RobotSwastaken/Amunicja/Dokumentacja/Robert Andrzejczuk Przezntacja SMIW.pdf

# SmiW

# Temat Projektu

## Urządzenie mające na celu zapobieganiu kradzieży pojazdu, w którym zostanie zamontowane, poprzez wykrywanie czy dany pojazd się porusza. Po wykryciu ruchu użądzenie zacyna co określony czas wysyłać widomości SMS na wybrany numer telefonu, zawierające

informacje o jego aktualnym położeniu.

# Elementy

### - Atmega 32A-PU

### - FIBOCOM G510 Q50-00 – GSM

### - FIBOCOM GTS-4E-60 – GPS

### - ADA 2809 – moduł zawierający akcelerometr LIS3DH

### - Bateria Litowo-Jonowa 3,7V

# Atmega 32A-PU

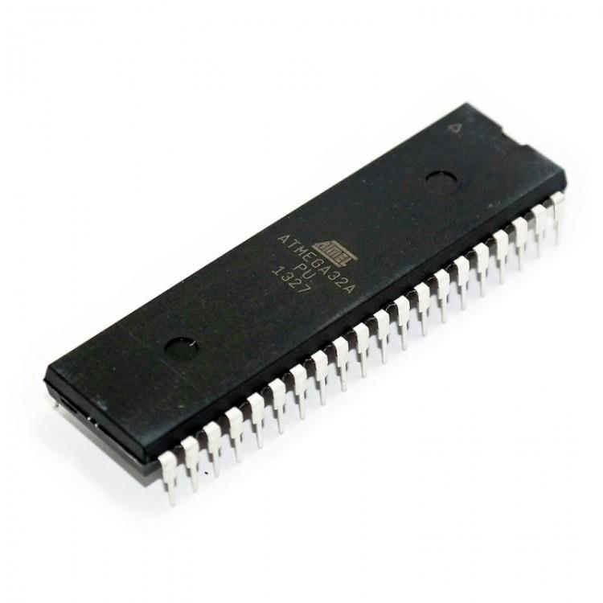
[picture p2: figure]

- Posiada interfejsy I2C ,SPI i UART
- Zasilanie napięciem 2,7-5,5V

# FIBOCOM G510 Q50-00

- Komunikacja przez UART

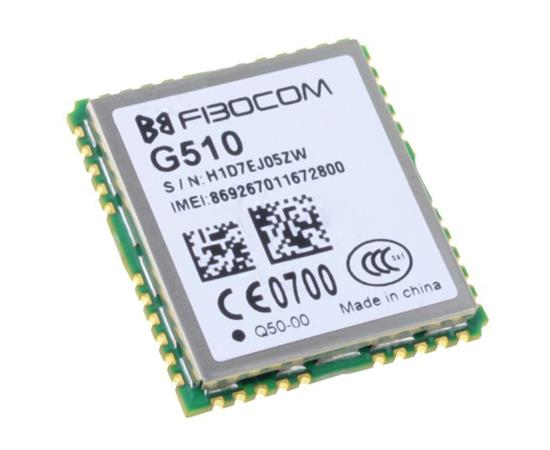
[picture p3: figure]

- Zasilanie napięciem 3,3-4,5V
- Cena

# FIBOCOM GTS-4E-60

- Komunikacja przez SPI orza UART
- Zasilanie napięciem 2,7-5,5V

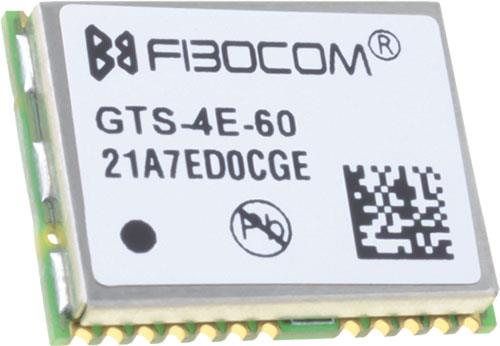
[picture p4: figure]

- Cena

# ADA 2809

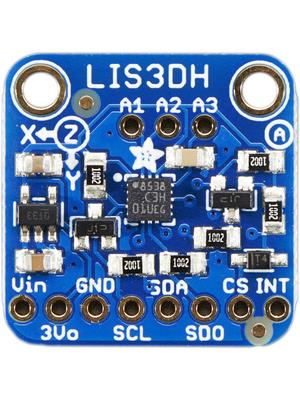
[picture p5: figure]

- Komunikacja przez I2C oraz SPI
- Zasilanie napięciem 2,7-5V
- Posiada akcelerometr LIS3DH, mierzący przyspieszenie w 3 osiach

# Schemat

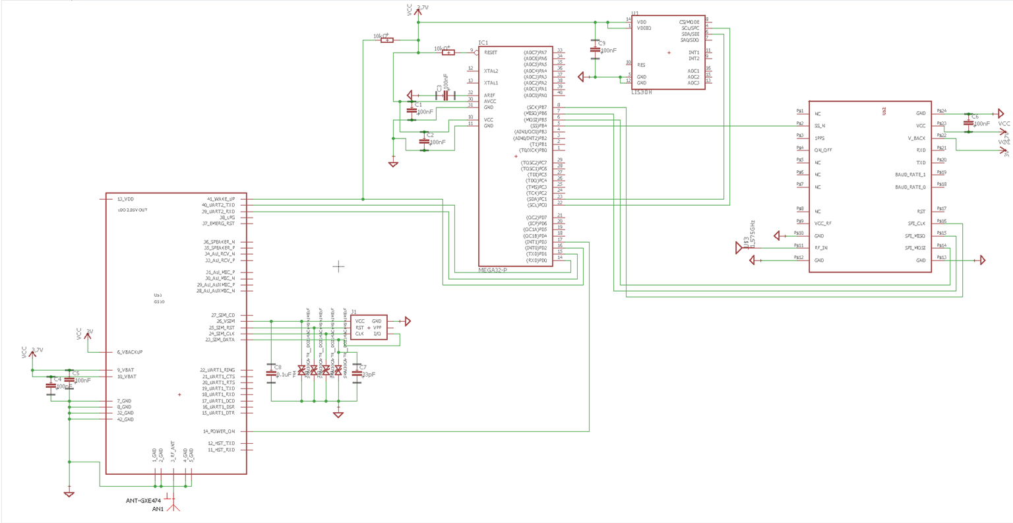
[picture p6: figure]
