RobotSwastaken/Amunicja/Hardware/PDF/G510 GSM_płytka.pdf

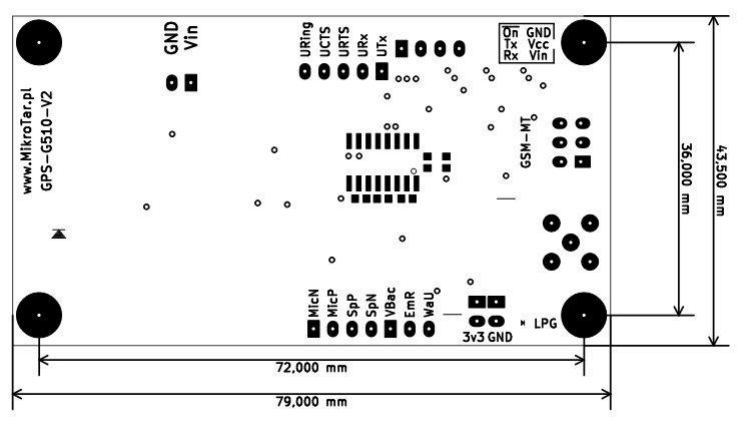
[picture p7: figure]
