RobotSwastaken/Amunicja/Hardware/PDF/NEO6MV2 flight control GPS_schemat.pdf

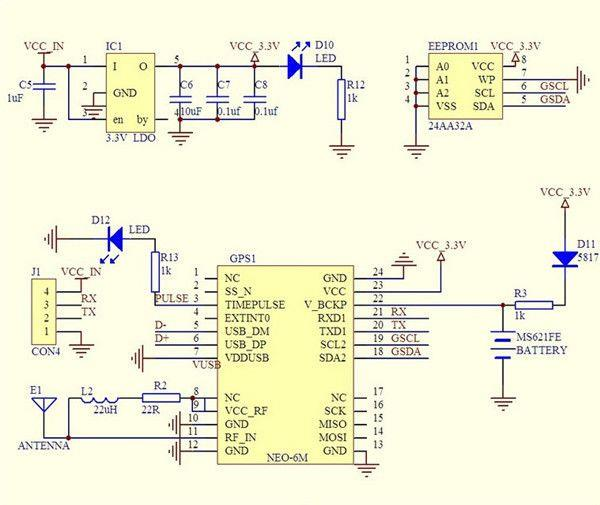
[picture p8: figure]
