RobotSwastaken/Amunicja/Hardware/PDF/Adafruit LIS3DH_schemat.pdf

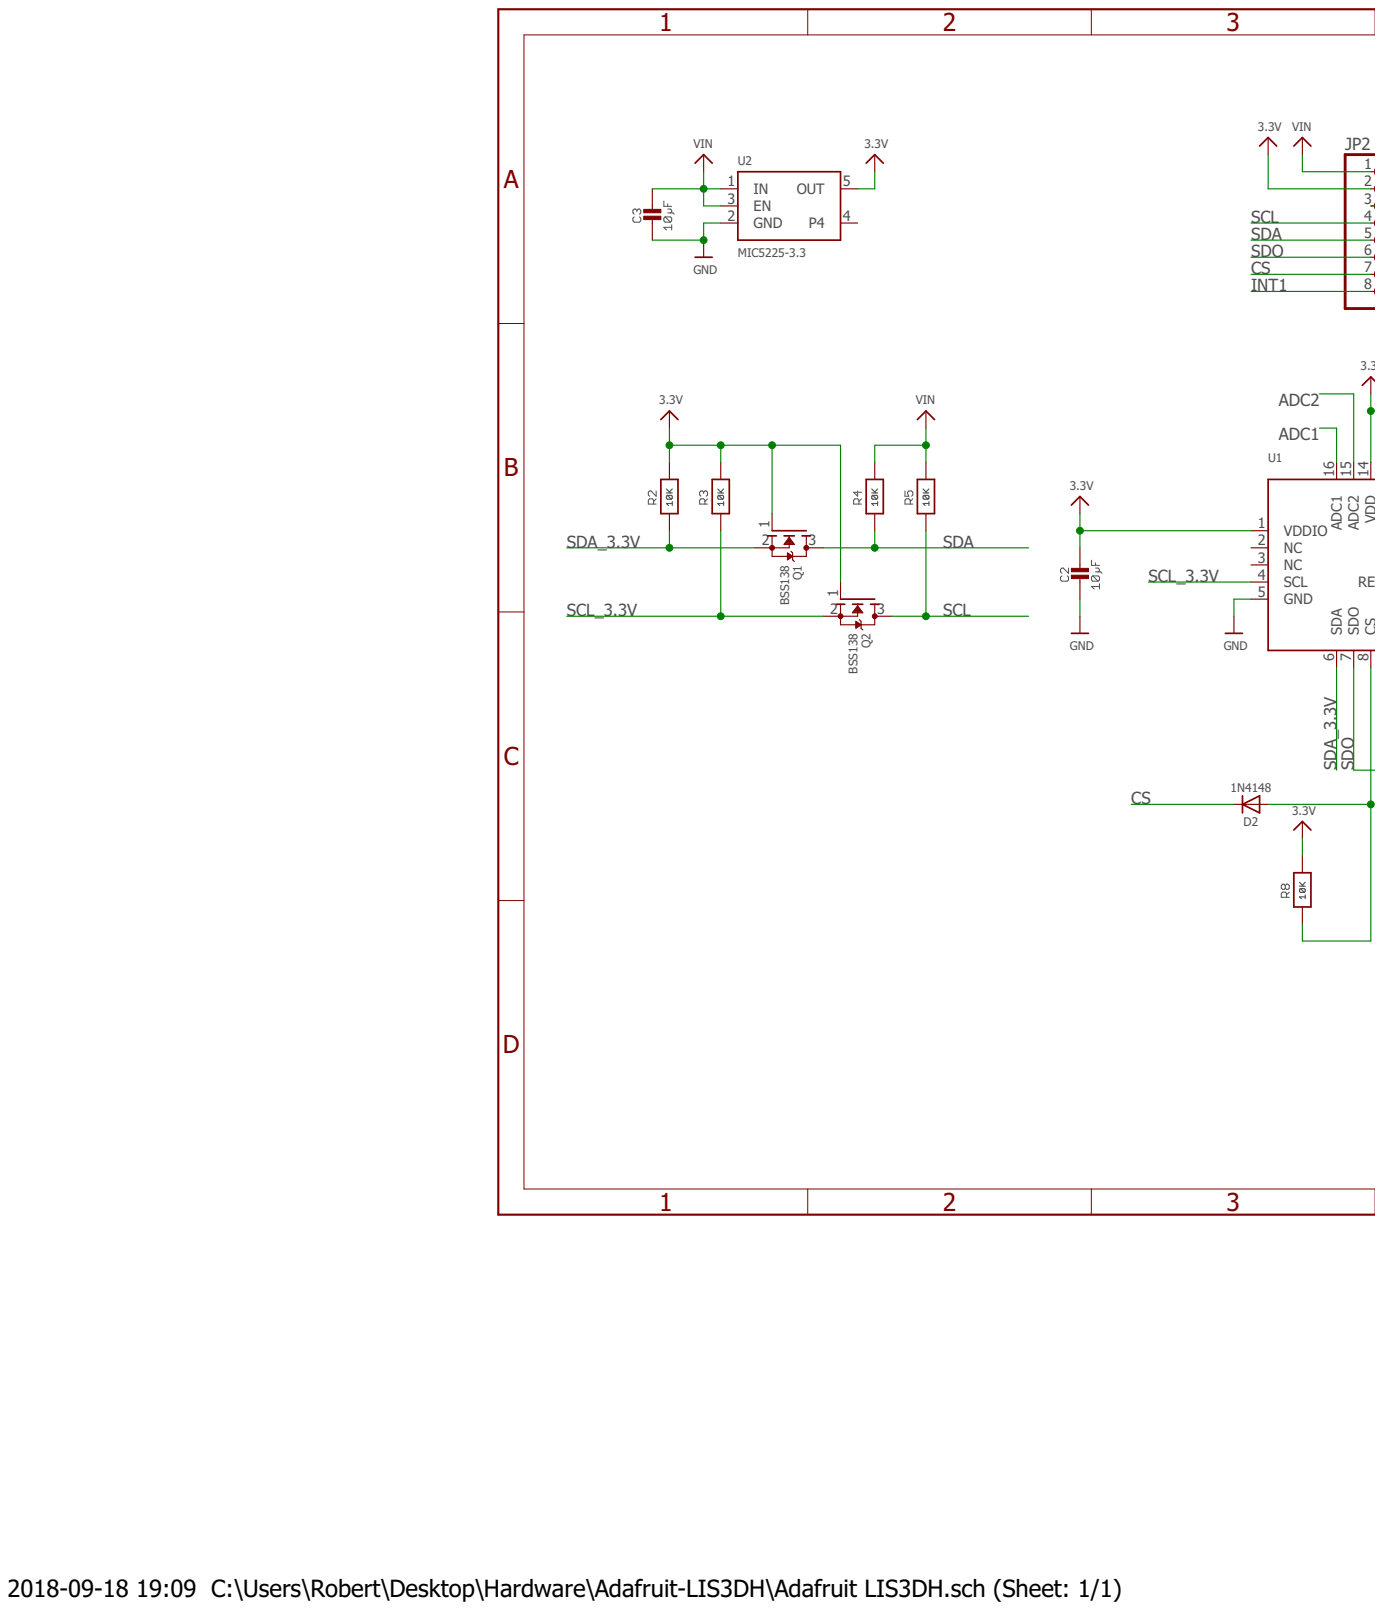
[picture p9: page 1]

2018-09-18 19:09 C:\Users\Robert\Desktop\Hardware\Adafruit-LIS3DH\Adafruit LIS3DH.sch (Sheet: 1/1)

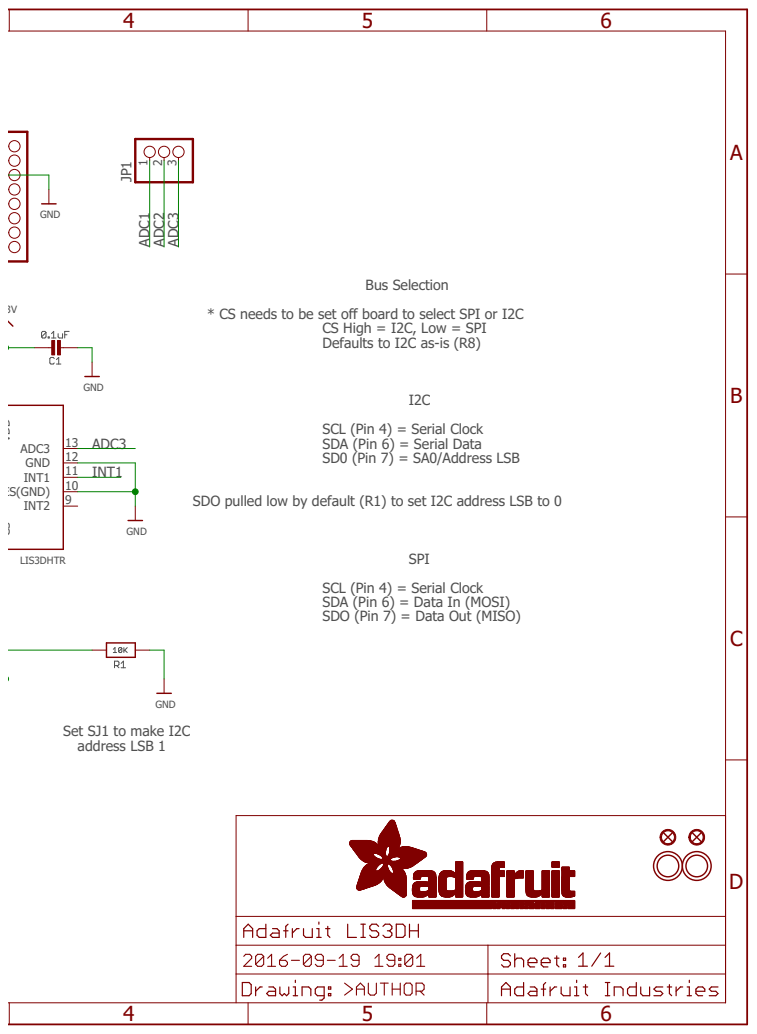
[picture p10: page 2]

* CS needs to be set off board to select SPI or I2C

CS High = I2C, Low = SPI
Defaults to I2C as-is (R8)

SCL (Pin 4) = Serial Clock
SDA (Pin 6) = Serial Data SD0 (Pin 7) = SA0/Address LSB

SDO pulled low by default (R1) to set I2C address LSB to 0

SDA (Pin 6) = Data In (MOSI)
SDO (Pin 7) = Data Out (MISO)
