RobotSwastaken/Amunicja/Hardware/PDF/Adafruit LIS3DH_płytka.pdf

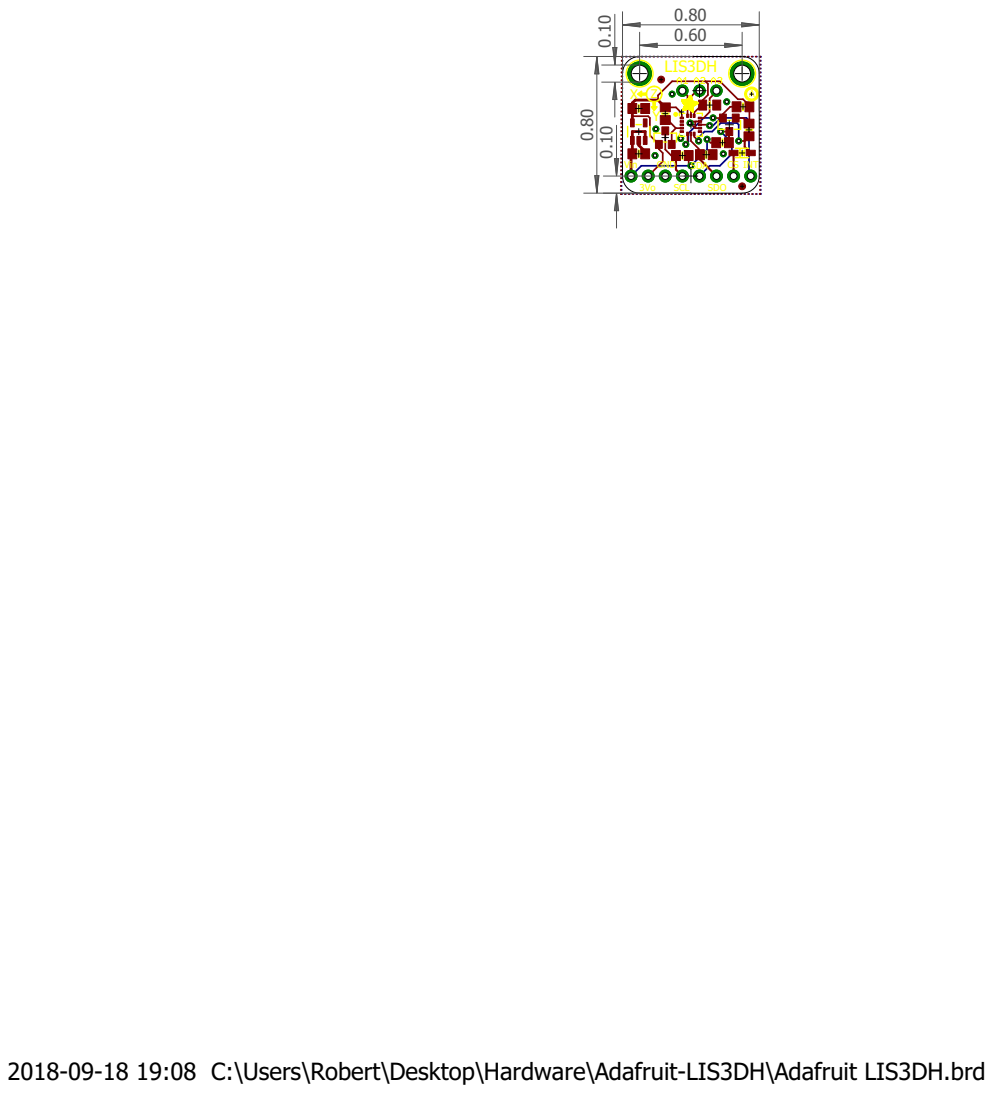
[picture p11: page 1]

2018-09-18 19:08 C:\Users\Robert\Desktop\Hardware\Adafruit-LIS3DH\Adafruit LIS3DH.brd
