RobotSwastaken/Amunicja/Hardware/PDF/Lokalizator_płytka.pdf

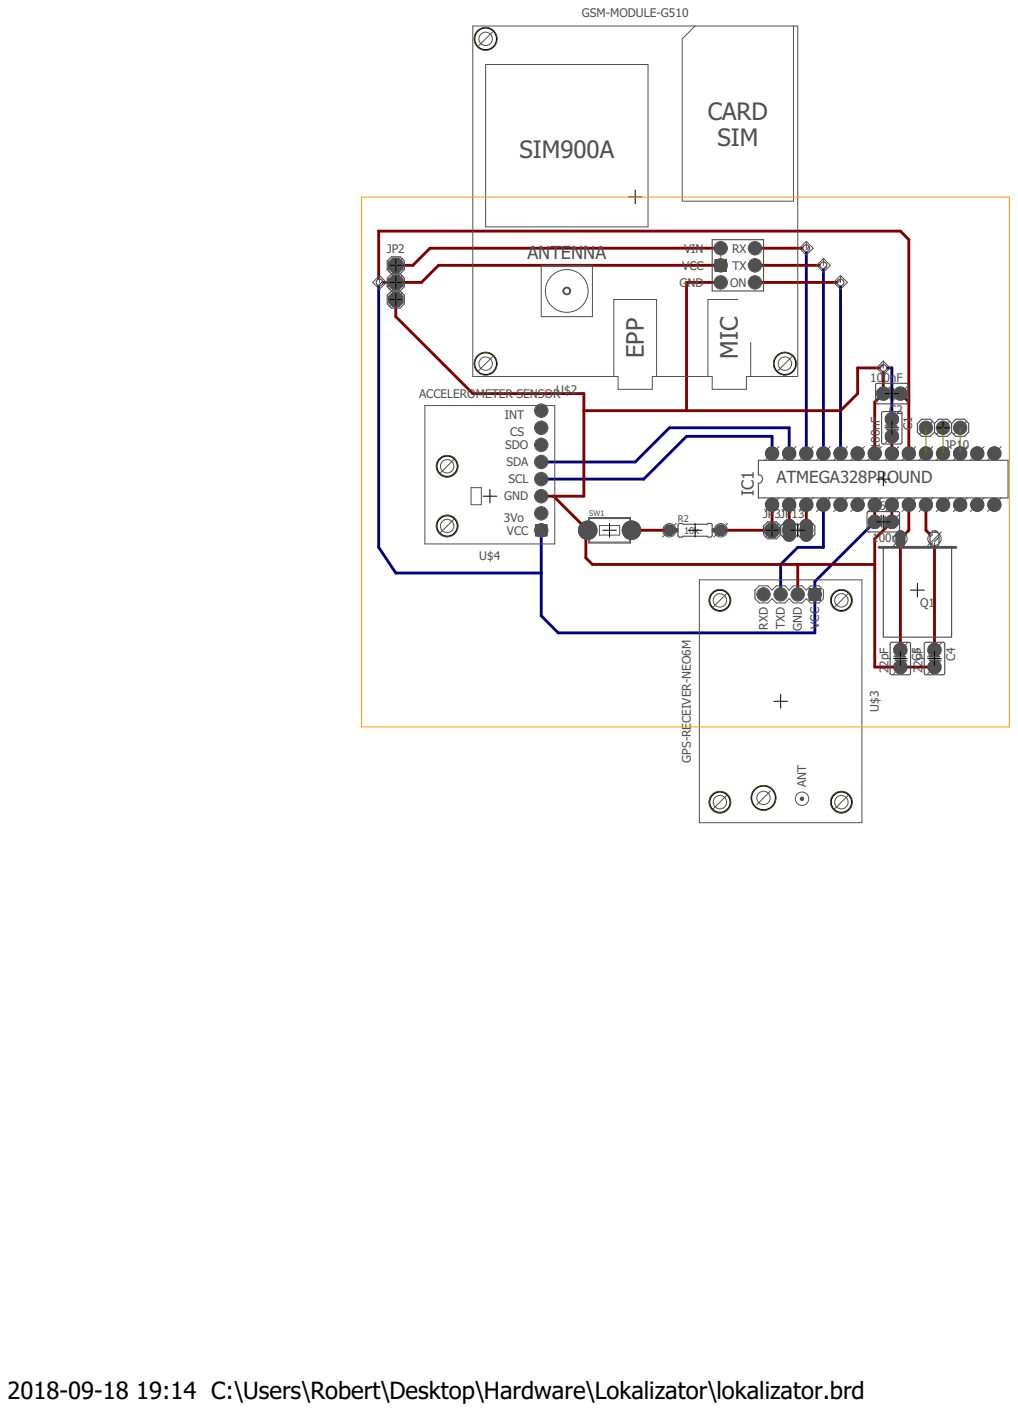
[picture p12: page 1]

2018-09-18 19:14 C:\Users\Robert\Desktop\Hardware\Lokalizator\lokalizator.brd
