RobotSwastaken/Amunicja/Hardware/PDF/Lokalizator_schemat.pdf

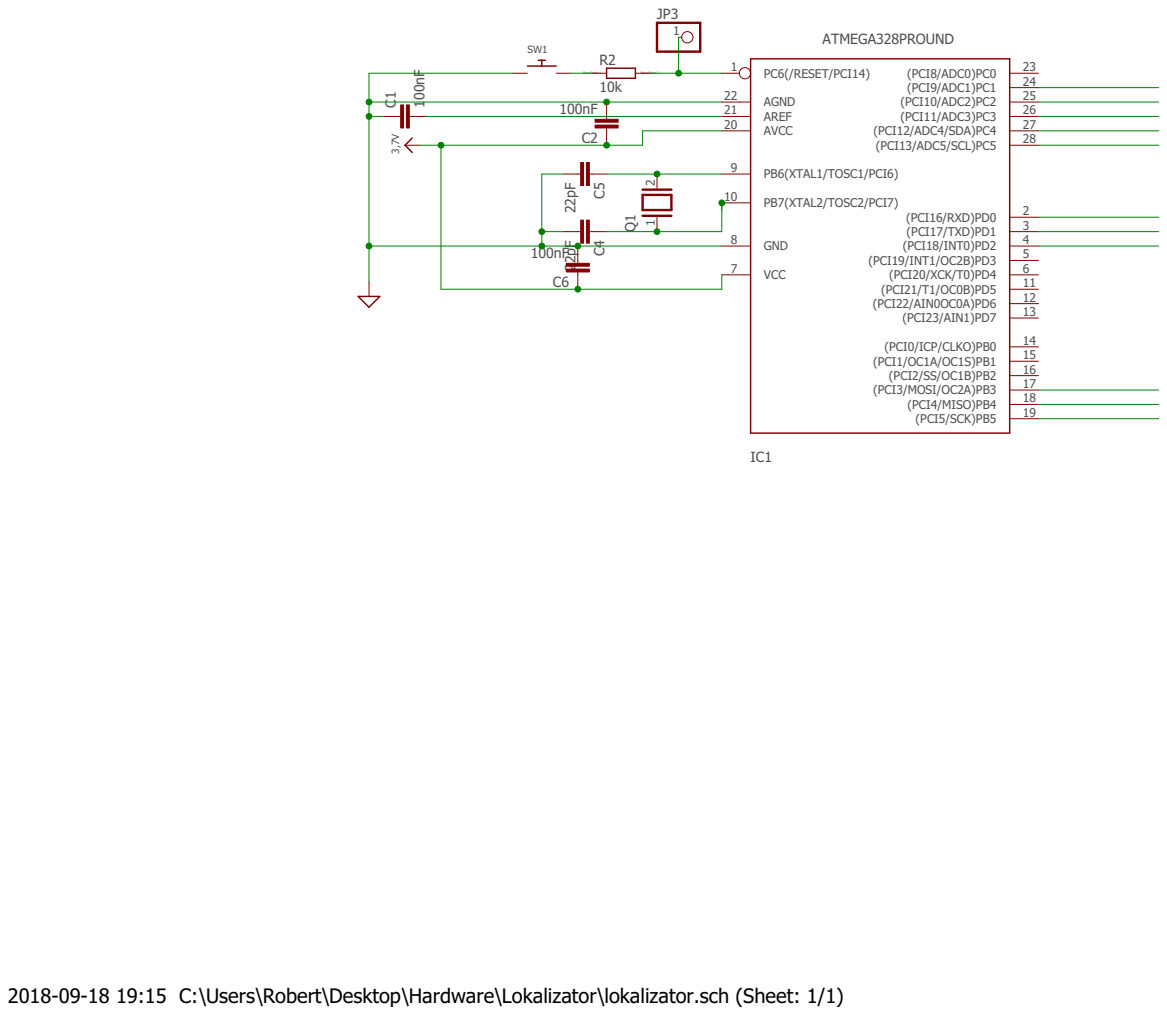
[picture p13: page 1]

2018-09-18 19:15 C:\Users\Robert\Desktop\Hardware\Lokalizator\lokalizator.sch (Sheet: 1/1)

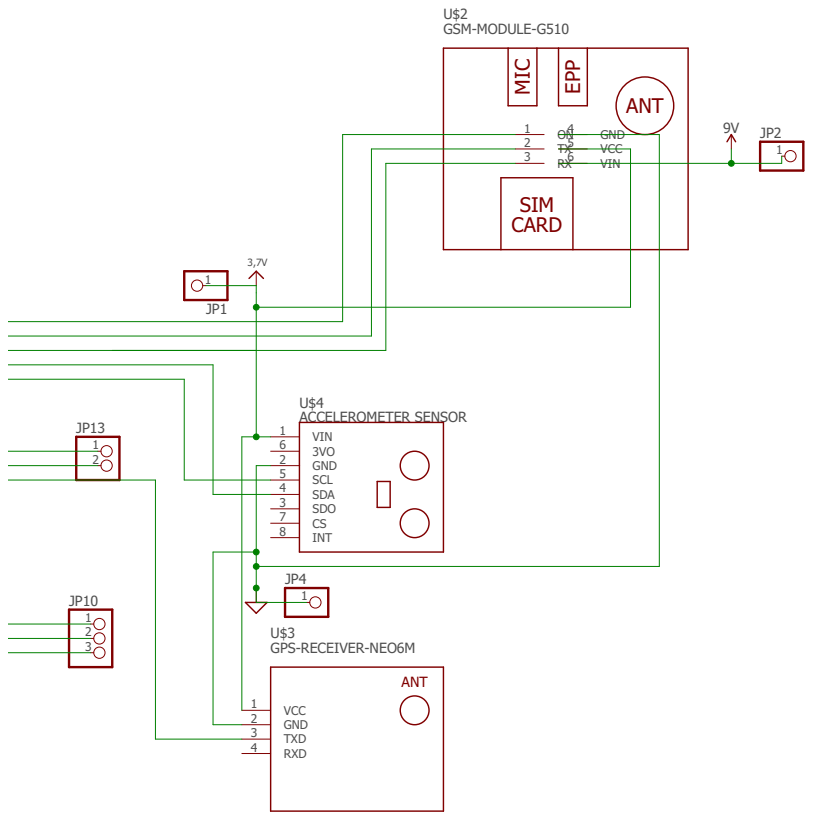
[picture p14: page 2]
