RobotSwastaken/Amunicja/Hardware/PDF/Lokalizator_plytka_uniwersalna_płytka.pdf

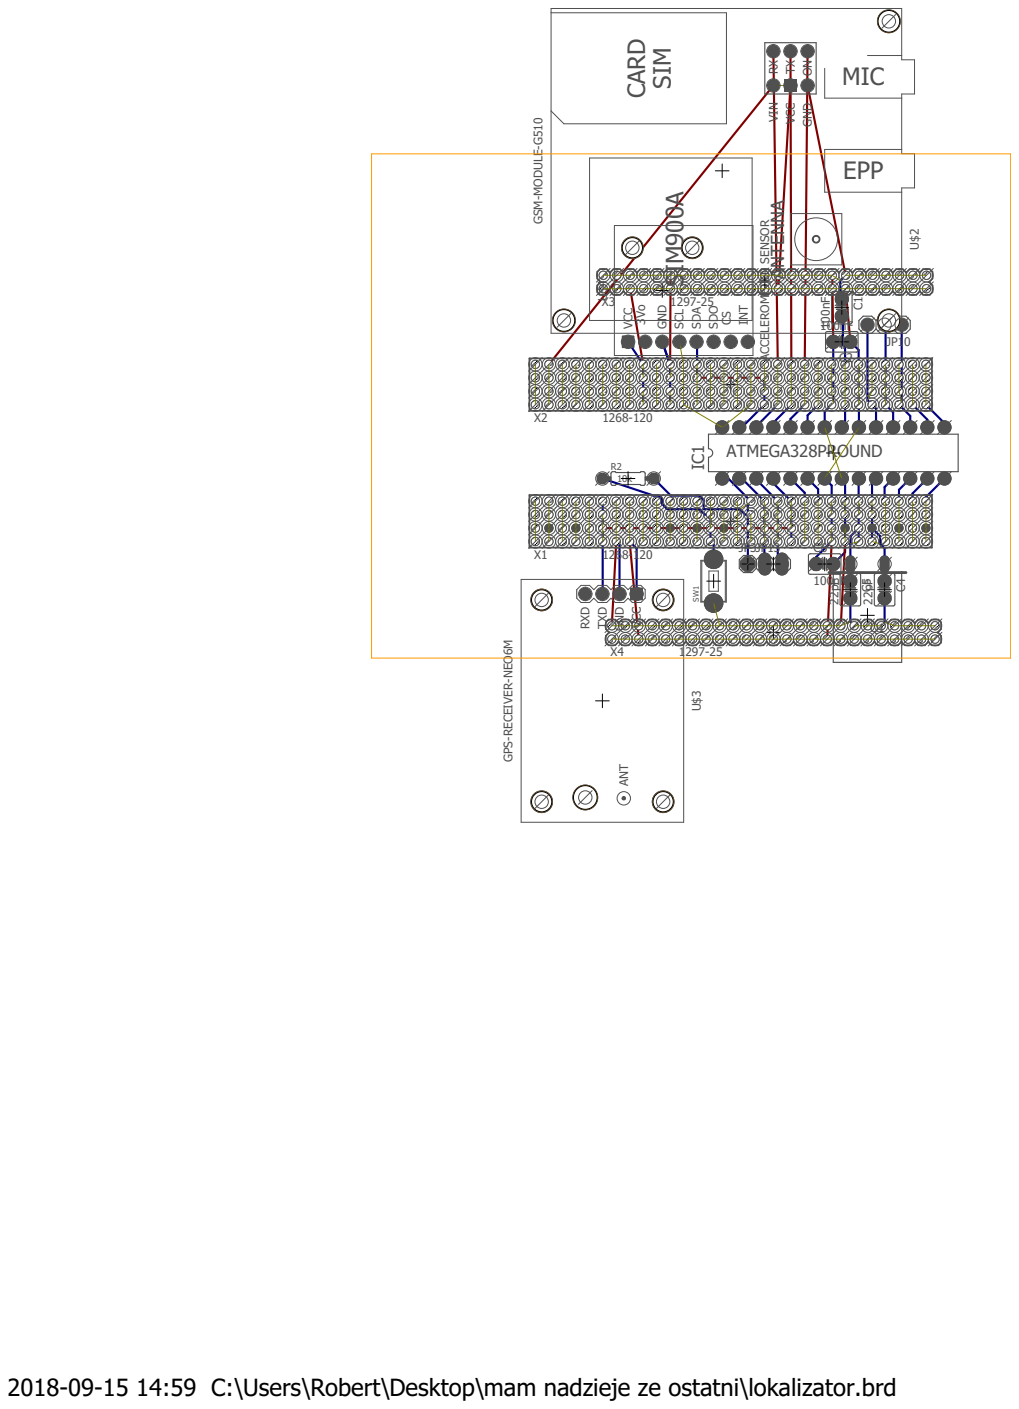
[picture p15: page 1]

2018-09-15 14:59 C:\Users\Robert\Desktop\mam nadzieje ze ostatni\lokalizator.brd
