RobotSwastaken/Amunicja/Hardware/PDF/Lokalizator_plytka_uniwersalna_schemat.pdf

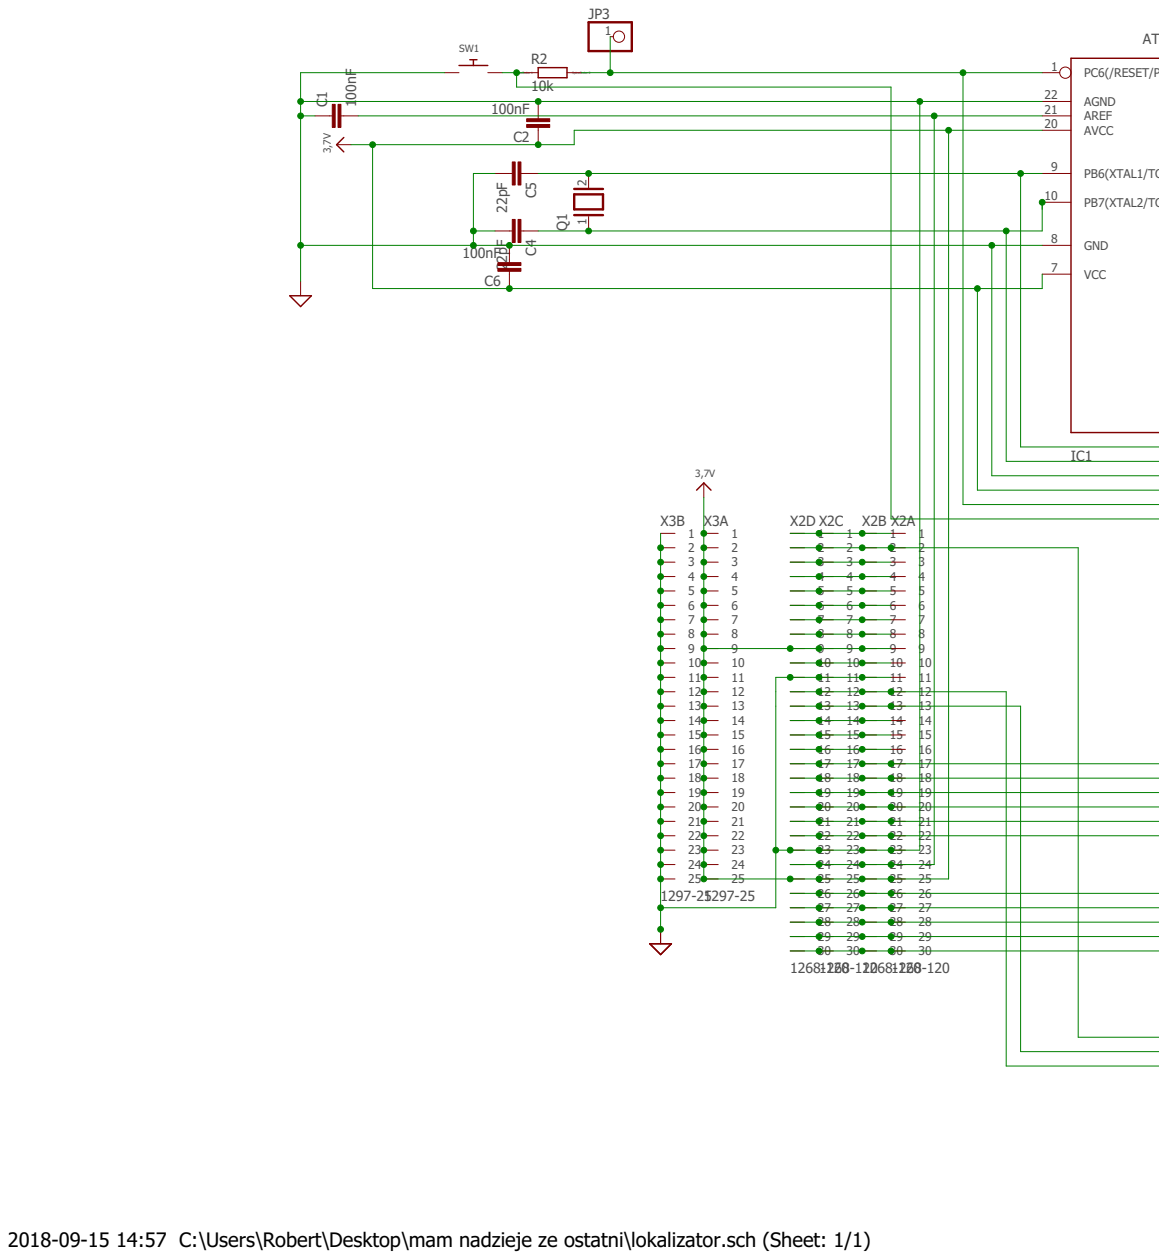
[picture p16: page 1]

2018-09-15 14:57 C:\Users\Robert\Desktop\mam nadzieje ze ostatni\lokalizator.sch (Sheet: 1/1)

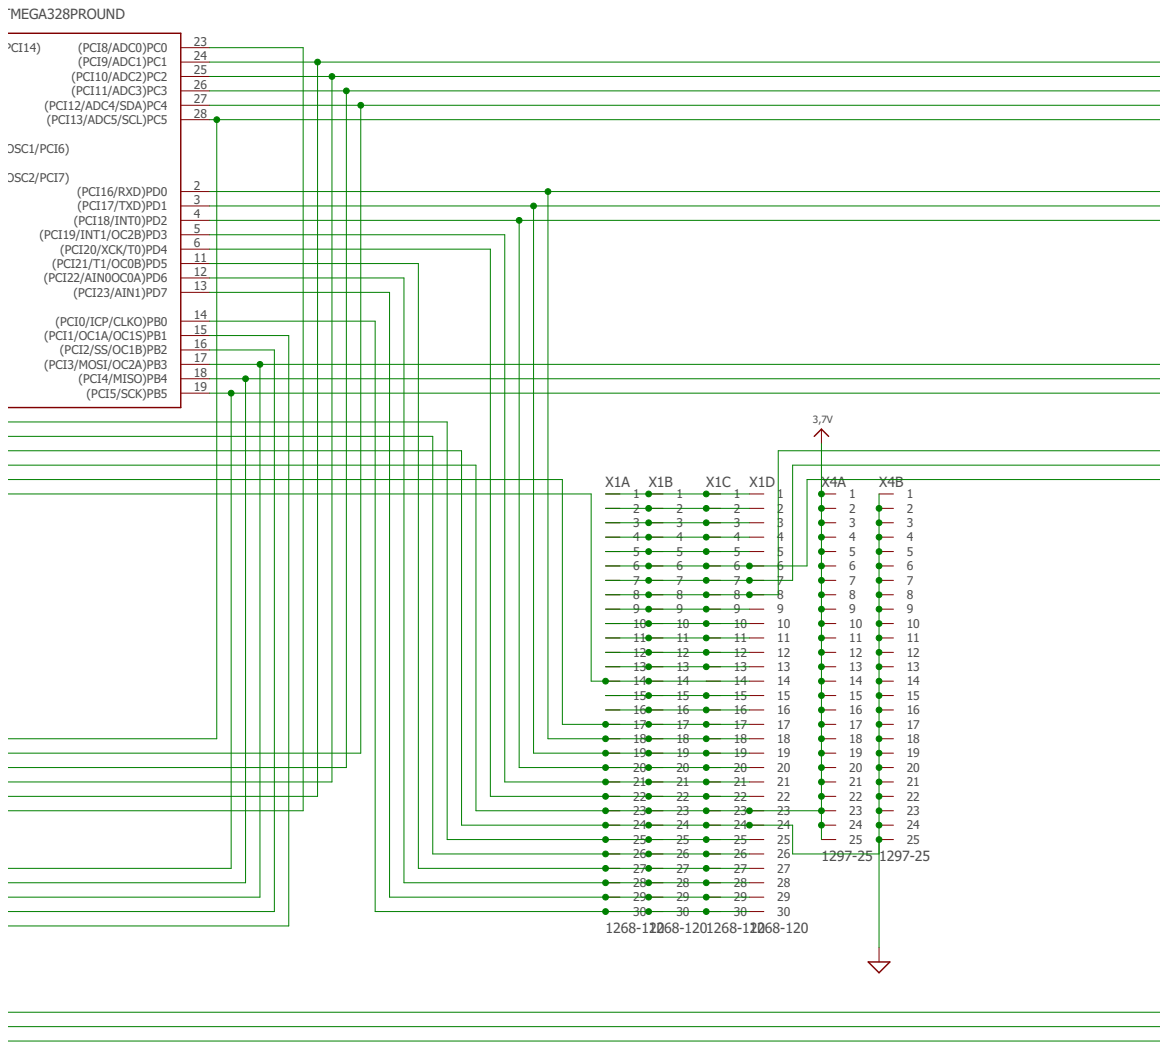
[picture p17: page 2]

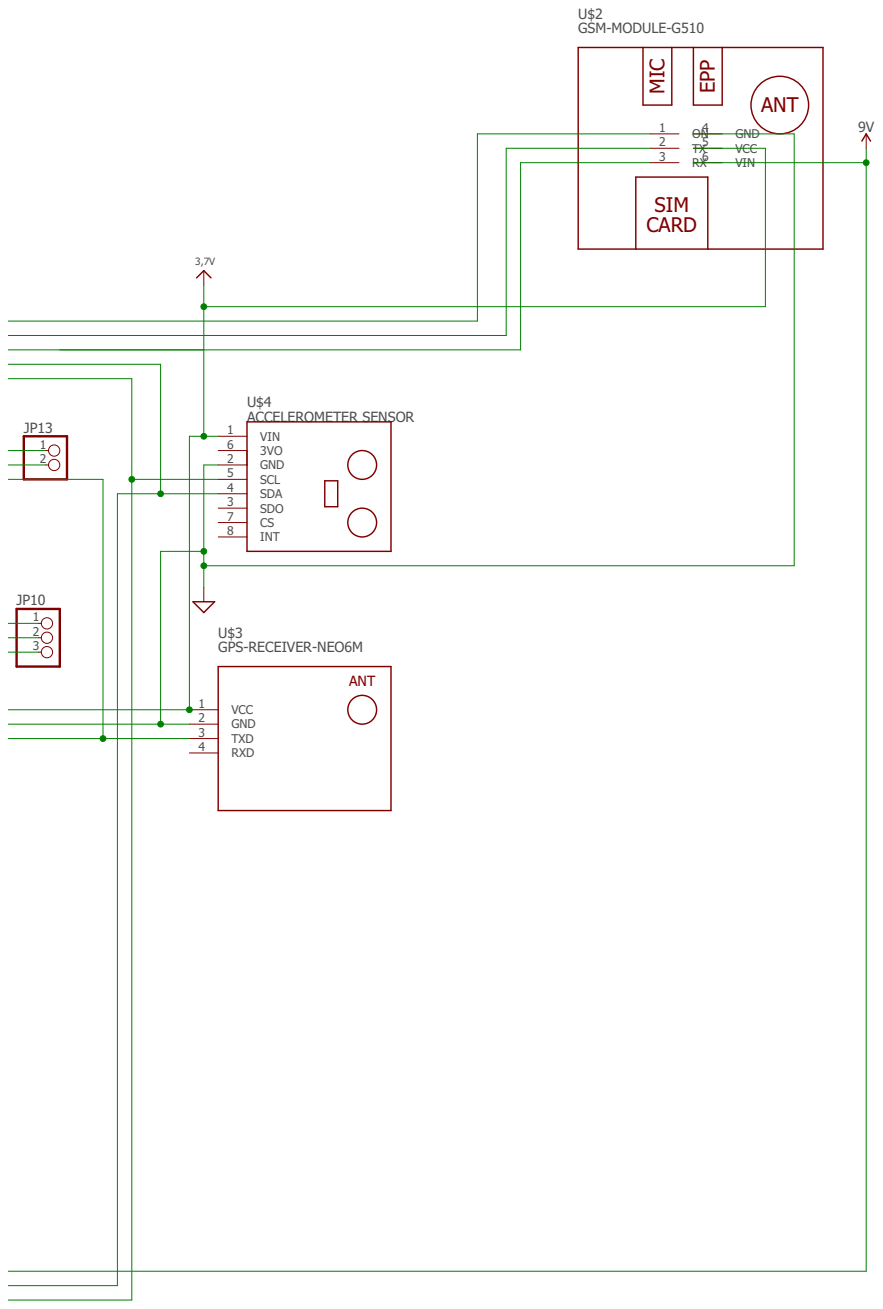
[picture p18: page 3]
