RobotSwastaken/Amunicja/Hardware/Lokalizator Płytka Uniwersalna/lokalizator_płytka_uniwersalna.brd

## EAGLE design Hardware/Lokalizator Płytka Uniwersalna/lokalizator_płytka_uniwersalna.brd (2018-09-11)

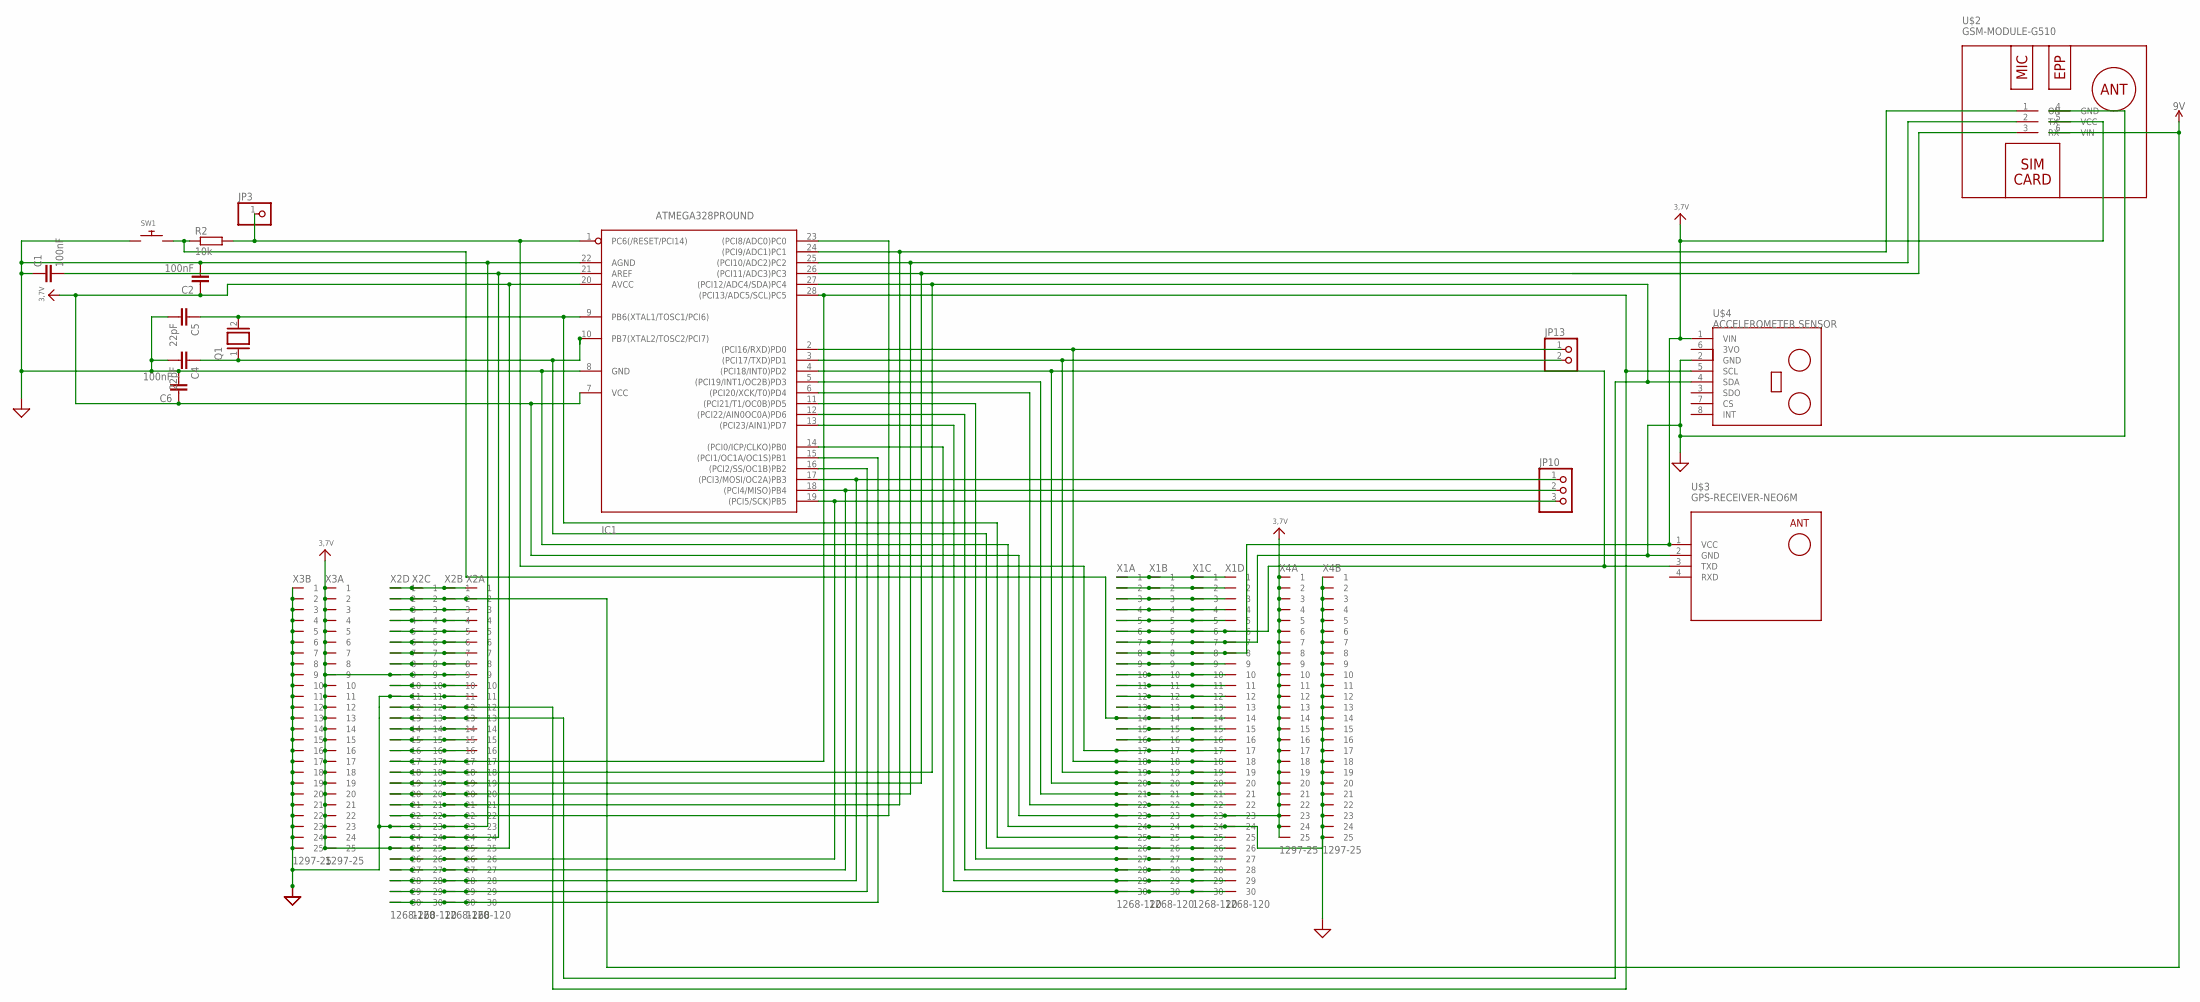
[picture p19: schematic lokalizator_płytka_uniwersalna.sch]

Parts:
C1, C2, C6: 100nF; C2.5-3
C4, C5: 22pF; C2.5-3
IC1: ATMEGA328PROUND; DIL28-3-ROUND
JP3: PINHD-1X1; 1X01
JP10: PINHD-1X3; 1X03
JP13: PINHD-1X2; 1X02
Q1: XTAL; Q
R2: 10k; 0204/7
SW1: SWITCH_PUSHBUTTONEVQ-PE; TACT_PANA-EVQ
U$2: GSM-MODULE-G510; GSM-MODEM-SIM900A
U$3: GPS-RECEIVER-NEO6M
U$4: ACCELEROMETER SENSOR; LIGHT-SENSOR-BH1750
X1, X2: 1268-120
X3, X4: 1297-25

Connections:
3VO: U$4.6 (3VO)
GND: C1.1, C2.2, C4.2, C5.2, C6.2, IC1.8 (GND), IC1.22 (AGND), SW1.P$1, U$2.4 (GND), U$3.2 (GND), U$4.2 (GND), X1.A7 (7), X1.A24 (24), X1.B7 (7), X1.B24 (24), X1.C7 (7), X1.C24 (24), X1.D7 (7), X1.D24 (24), X2.A11 (11), X2.A23 (23), X2.B11 (11), X2.B23 (23), X2.C11 (11), X2.C23 (23), X2.D11 (11), X2.D23 (23), X3.B1 (1), X3.B2 (2), X3.B3 (3), X3.B4 (4), X3.B5 (5), X3.B6 (6), X3.B7 (7), X3.B8 (8), X3.B9 (9), X3.B10 (10), X3.B11 (11), X3.B12 (12), X3.B13 (13), X3.B14 (14), X3.B15 (15), X3.B16 (16), X3.B17 (17), X3.B18 (18), X3.B19 (19), X3.B20 (20), X3.B21 (21), X3.B22 (22), X3.B23 (23), X3.B24 (24), X3.B25 (25), X4.B1 (1), X4.B2 (2), X4.B3 (3), X4.B4 (4), X4.B5 (5), X4.B6 (6), X4.B7 (7), X4.B8 (8), X4.B9 (9), X4.B10 (10), X4.B11 (11), X4.B12 (12), X4.B13 (13), X4.B14 (14), X4.B15 (15), X4.B16 (16), X4.B17 (17), X4.B18 (18), X4.B19 (19), X4.B20 (20), X4.B21 (21), X4.B22 (22), X4.B23 (23), X4.B24 (24), X4.B25 (25)
unnamed: R2.1, SW1.P$2, X1.A14 (14), X1.B14 (14), X1.C14 (14), X1.D14 (14)
unnamed: IC1.1 (PC6(/RESET/PCI14)), JP3.1, R2.2, X1.A17 (17), X1.B17 (17), X1.C17 (17), X1.D17 (17)
unnamed: C1.2, IC1.21 (AREF), X2.A24 (24), X2.B24 (24), X2.C24 (24), X2.D24 (24)
unnamed: IC1.19 ((PCI5/SCK)PB5), JP10.3, X2.A26 (26), X2.B26 (26), X2.C26 (26), X2.D26 (26)
unnamed: C5.1, IC1.9 (PB6(XTAL1/TOSC1/PCI6)), Q1.2, X1.A25 (25), X1.B25 (25), X1.C25 (25), X1.D25 (25)
unnamed: C4.1, IC1.10 (PB7(XTAL2/TOSC2/PCI7)), Q1.1, X1.A26 (26), X1.B26 (26), X1.C26 (26), X1.D26 (26)
unnamed: IC1.18 ((PCI4/MISO)PB4), JP10.2, X2.A27 (27), X2.B27 (27), X2.C27 (27), X2.D27 (27)
unnamed: IC1.17 ((PCI3/MOSI/OC2A)PB3), JP10.1, X2.A28 (28), X2.B28 (28), X2.C28 (28), X2.D28 (28)
unnamed: IC1.14 ((PCI0/ICP/CLKO)PB0), X1.A30 (30), X1.B30 (30), X1.C30 (30), X1.D30 (30)
unnamed: IC1.28 ((PCI13/ADC5/SCL)PC5), U$4.5 (SCL), X2.A12 (12), X2.A17 (17), X2.B12 (12), X2.B17 (17), X2.C12 (12), X2.C17 (17), X2.D12 (12), X2.D17 (17)
unnamed: X1.A16 (16), X1.B16 (16), X1.C16 (16), X1.D16 (16)
unnamed: IC1.4 ((PCI18/INT0)PD2), U$3.3 (TXD), X1.A6 (6), X1.A20 (20), X1.B6 (6), X1.B20 (20), X1.C6 (6), X1.C20 (20), X1.D6 (6), X1.D20 (20)
unnamed: IC1.24 ((PCI9/ADC1)PC1), U$2.1 (ON), X2.A21 (21), X2.B21 (21), X2.C21 (21), X2.D21 (21)
unnamed: IC1.2 ((PCI16/RXD)PD0), JP13.1, X1.A18 (18), X1.B18 (18), X1.C18 (18), X1.D18 (18)
unnamed: IC1.3 ((PCI17/TXD)PD1), JP13.2, X1.A19 (19), X1.B19 (19), X1.C19 (19), X1.D19 (19)
unnamed: IC1.25 ((PCI10/ADC2)PC2), U$2.2 (TX), X2.A20 (20), X2.B20 (20), X2.C20 (20), X2.D20 (20)
unnamed: IC1.26 ((PCI11/ADC3)PC3), U$2.3 (RX), X2.A19 (19), X2.B19 (19), X2.C19 (19), X2.D19 (19)
unnamed: IC1.15 ((PCI1/OC1A/OC1S)PB1), X2.A30 (30), X2.B30 (30), X2.C30 (30), X2.D30 (30)
unnamed: IC1.16 ((PCI2/SS/OC1B)PB2), X2.A29 (29), X2.B29 (29), X2.C29 (29), X2.D29 (29)
unnamed: IC1.13 ((PCI23/AIN1)PD7), X1.A29 (29), X1.B29 (29), X1.C29 (29), X1.D29 (29)
unnamed: IC1.12 ((PCI22/AIN0OC0A)PD6), X1.A28 (28), X1.B28 (28), X1.C28 (28), X1.D28 (28)
unnamed: IC1.11 ((PCI21/T1/OC0B)PD5), X1.A27 (27), X1.B27 (27), X1.C27 (27), X1.D27 (27)
unnamed: IC1.23 ((PCI8/ADC0)PC0), X2.A22 (22), X2.B22 (22), X2.C22 (22), X2.D22 (22)
unnamed: IC1.5 ((PCI19/INT1/OC2B)PD3), X1.A21 (21), X1.B21 (21), X1.C21 (21), X1.D21 (21)
unnamed: IC1.27 ((PCI12/ADC4/SDA)PC4), U$4.4 (SDA), X2.A13 (13), X2.A18 (18), X2.B13 (13), X2.B18 (18), X2.C13 (13), X2.C18 (18), X2.D13 (13), X2.D18 (18)
unnamed: IC1.6 ((PCI20/XCK/T0)PD4), X1.A22 (22), X1.B22 (22), X1.C22 (22), X1.D22 (22)
unnamed: X1.A15 (15), X1.B15 (15), X1.C15 (15), X1.D15 (15)
unnamed: X1.A13 (13), X1.B13 (13), X1.C13 (13), X1.D13 (13)
unnamed: X1.A12 (12), X1.B12 (12), X1.C12 (12), X1.D12 (12)
unnamed: X1.A11 (11), X1.B11 (11), X1.C11 (11), X1.D11 (11)
unnamed: X1.A10 (10), X1.B10 (10), X1.C10 (10), X1.D10 (10)
unnamed: X1.A9 (9), X1.B9 (9), X1.C9 (9), X1.D9 (9)
unnamed: X1.A5 (5), X1.B5 (5), X1.C5 (5), X1.D5 (5)
unnamed: X1.A4 (4), X1.B4 (4), X1.C4 (4), X1.D4 (4)
unnamed: X1.A3 (3), X1.B3 (3), X1.C3 (3), X1.D3 (3)
unnamed: X1.A2 (2), X1.B2 (2), X1.C2 (2), X1.D2 (2)
unnamed: X1.A1 (1), X1.B1 (1), X1.C1 (1), X1.D1 (1)
unnamed: X2.A16 (16), X2.B16 (16), X2.C16 (16), X2.D16 (16)
unnamed: X2.A15 (15), X2.B15 (15), X2.C15 (15), X2.D15 (15)
unnamed: X2.A14 (14), X2.B14 (14), X2.C14 (14), X2.D14 (14)
unnamed: X2.A10 (10), X2.B10 (10), X2.C10 (10), X2.D10 (10)
unnamed: X2.A8 (8), X2.B8 (8), X2.C8 (8), X2.D8 (8)
unnamed: X2.A7 (7), X2.B7 (7), X2.C7 (7), X2.D7 (7)
unnamed: X2.A6 (6), X2.B6 (6), X2.C6 (6), X2.D6 (6)
unnamed: X2.A5 (5), X2.B5 (5), X2.C5 (5), X2.D5 (5)
unnamed: X2.A4 (4), X2.B4 (4), X2.C4 (4), X2.D4 (4)
unnamed: X2.A3 (3), X2.B3 (3), X2.C3 (3), X2.D3 (3)
unnamed: X2.A1 (1), X2.B1 (1), X2.C1 (1), X2.D1 (1)
RXD: U$3.4 (RXD)
VCC: C2.1, C6.1, IC1.7 (VCC), IC1.20 (AVCC), U$2.5 (VCC), U$2.6 (VIN), U$3.1 (VCC), U$4.1 (VIN), X1.A8 (8), X1.A23 (23), X1.B8 (8), X1.B23 (23), X1.C8 (8), X1.C23 (23), X1.D8 (8), X1.D23 (23), X2.A2 (2), X2.A9 (9), X2.A25 (25), X2.B2 (2), X2.B9 (9), X2.B25 (25), X2.C2 (2), X2.C9 (9), X2.C25 (25), X2.D2 (2), X2.D9 (9), X2.D25 (25), X3.A1 (1), X3.A2 (2), X3.A3 (3), X3.A4 (4), X3.A5 (5), X3.A6 (6), X3.A7 (7), X3.A8 (8), X3.A9 (9), X3.A10 (10), X3.A11 (11), X3.A12 (12), X3.A13 (13), X3.A14 (14), X3.A15 (15), X3.A16 (16), X3.A17 (17), X3.A18 (18), X3.A19 (19), X3.A20 (20), X3.A21 (21), X3.A22 (22), X3.A23 (23), X3.A24 (24), X3.A25 (25), X4.A1 (1), X4.A2 (2), X4.A3 (3), X4.A4 (4), X4.A5 (5), X4.A6 (6), X4.A7 (7), X4.A8 (8), X4.A9 (9), X4.A10 (10), X4.A11 (11), X4.A12 (12), X4.A13 (13), X4.A14 (14), X4.A15 (15), X4.A16 (16), X4.A17 (17), X4.A18 (18), X4.A19 (19), X4.A20 (20), X4.A21 (21), X4.A22 (22), X4.A23 (23), X4.A24 (24), X4.A25 (25)

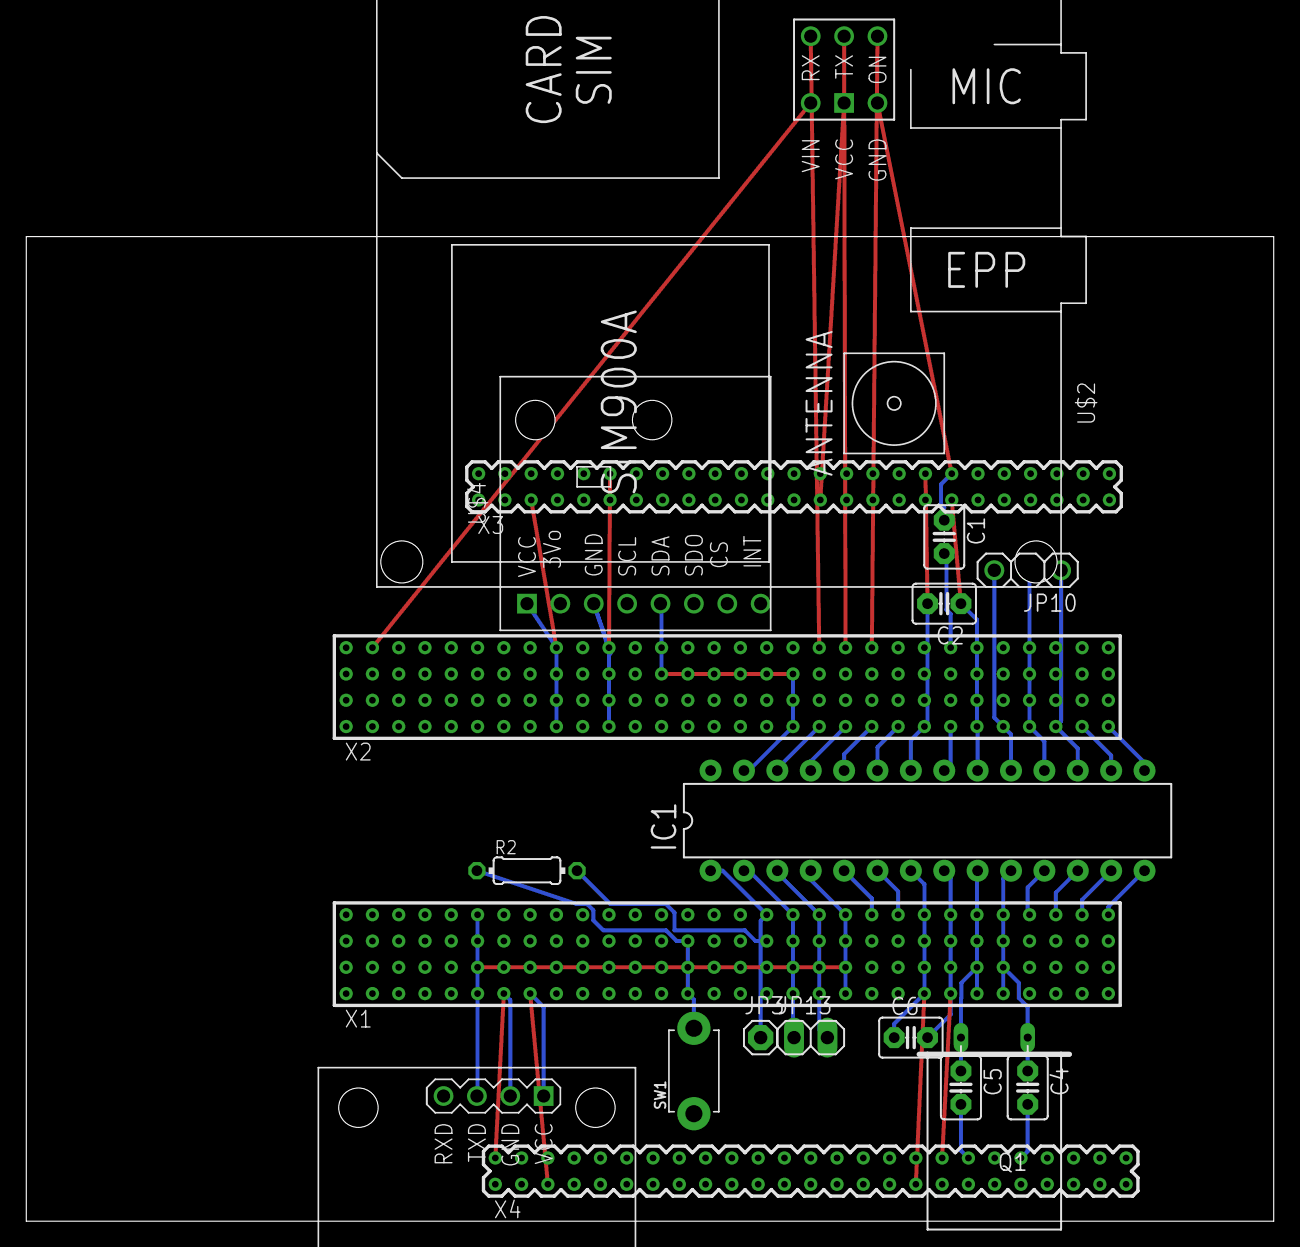
[picture p20: board lokalizator_płytka_uniwersalna.brd from above]

Board: 2 copper layers, 94.9 x 74.9 mm, 19 parts (0 on the bottom side), 50 nets.
