RobotSwastaken/Amunicja/Hardware/Adafruit-LIS3DH/Adafruit LIS3DH.brd

## EAGLE design Hardware/Adafruit-LIS3DH/Adafruit LIS3DH.brd (2018-09-18)

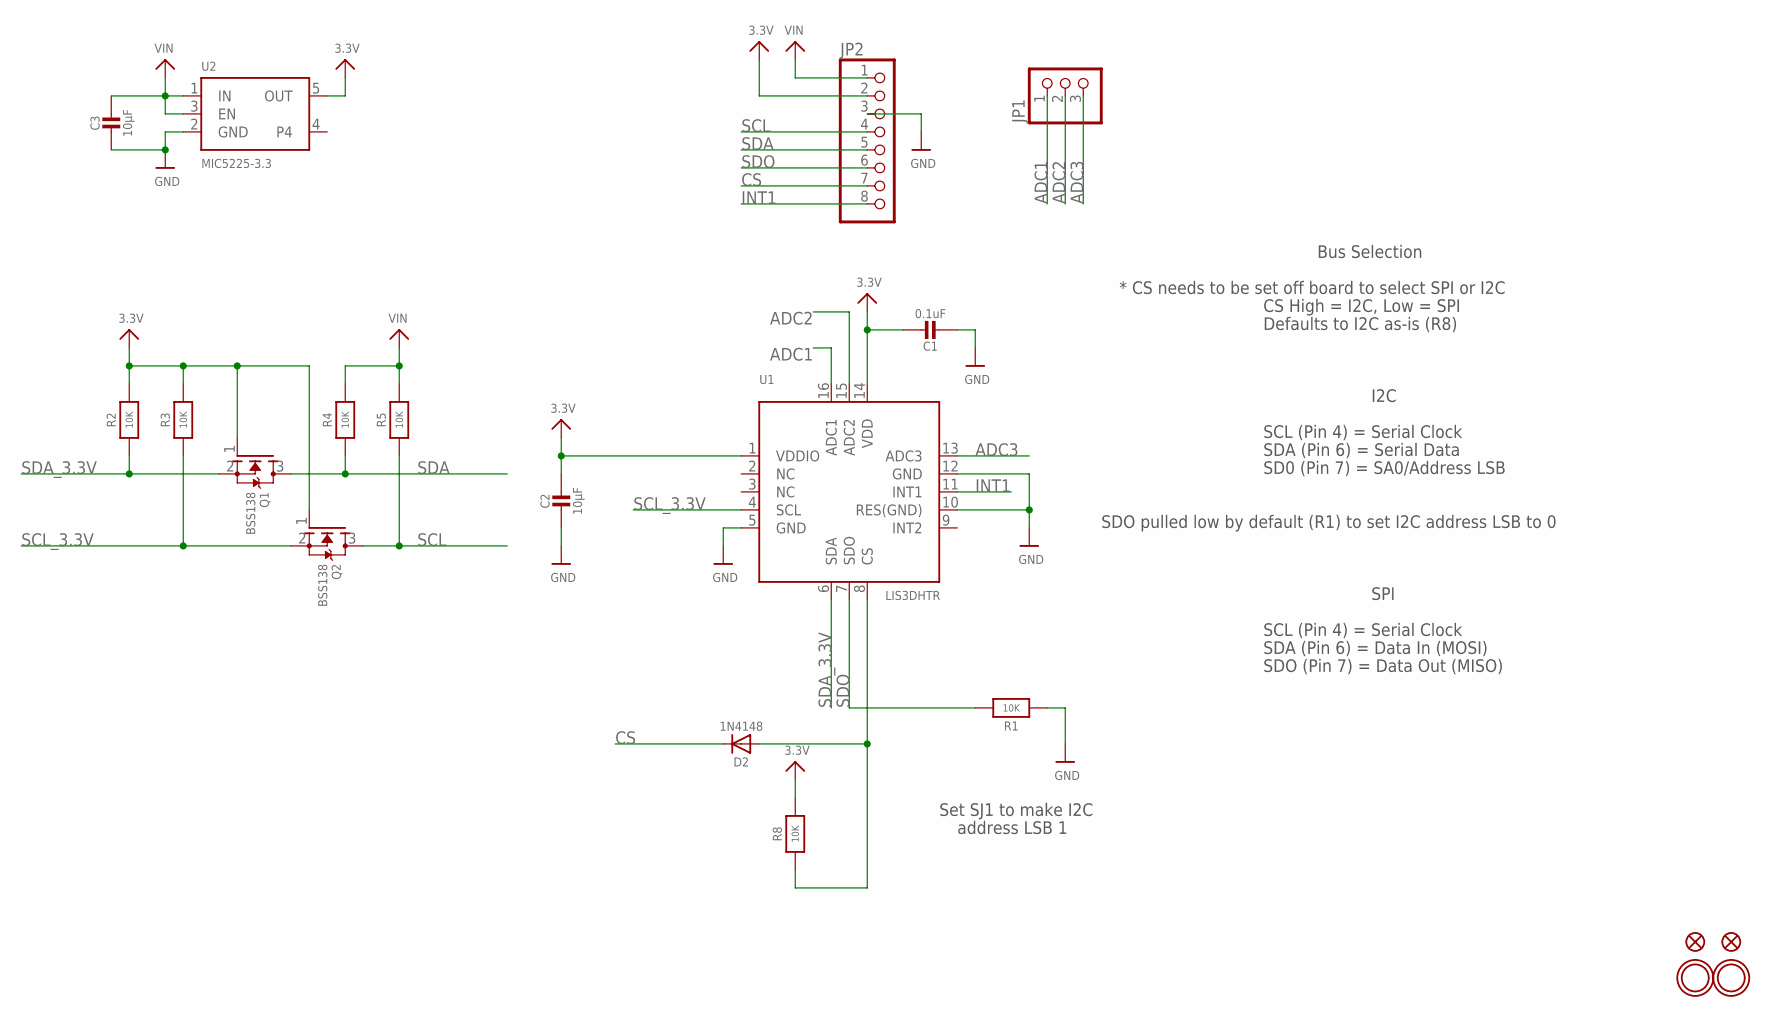
[picture p21: schematic Adafruit LIS3DH.sch]

Parts:
C1: 0.1uF; 0805_10MGAP
C2, C3: 10µF; 0805-NO
D2: 1N4148; SOD-323
FID1, FID2: FIDUCIAL""; FIDUCIAL_1MM
JP1: HEADER-1X3ROUND; 1X03_ROUND
JP2: HEADER-1X870MIL; 1X08_ROUND_70
Q1, Q2: BSS138; SOT23-WIDE
R1, R2, R3, R4, R5, R8: 10K; 0805-NO
U1: LIS3DHTR; LGA16_3X3MM
U2: MIC5225-3.3; SOT23-5
U$10, U$13: MOUNTINGHOLE2.5; MOUNTINGHOLE_2.5_PLATED

Connections:
3.3V: C1.1, C2.1, JP2.2, Q1.1 (G), Q2.1 (G), R2.2, R3.2, R8.2, U1.1 (VDDIO), U1.14 (VDD), U2.5 (OUT)
ADC1: JP1.1, U1.16 (ADC1)
ADC2: JP1.2, U1.15 (ADC2)
ADC3: JP1.3, U1.13 (ADC3)
CS: D2.C, JP2.7
GND: C1.2, C2.2, C3.2, JP2.3, R1.1, U1.5 (GND), U1.10 (RES(GND)), U1.12 (GND), U2.2 (GND)
INT1: JP2.8, U1.11 (INT1)
unnamed: D2.A, R8.1, U1.8 (CS)
SCL: JP2.4, Q2.3 (D), R5.1
SCL_3.3V: Q2.2 (S), R3.1, U1.4 (SCL)
SDA: JP2.5, Q1.3 (D), R4.1
SDA_3.3V: Q1.2 (S), R2.1, U1.6 (SDA)
SDO: JP2.6, R1.2, U1.7 (SDO)
VIN: C3.1, JP2.1, R4.2, R5.2, U2.1 (IN), U2.3 (EN)

Notes on the sheet:
I2C
SCL (Pin 4) = Serial Clock
SDA (Pin 6) = Serial Data
SD0 (Pin 7) = SA0/Address LSB
* CS needs to be set off board to select SPI or I2C
CS High = I2C, Low = SPI
Defaults to I2C as-is (R8)
SDO pulled low by default (R1) to set I2C address LSB to 0
Bus Selection
SPI
SDA (Pin 6) = Data In (MOSI)
SDO (Pin 7) = Data Out (MISO)
Set SJ1 to make I2C
address LSB 1

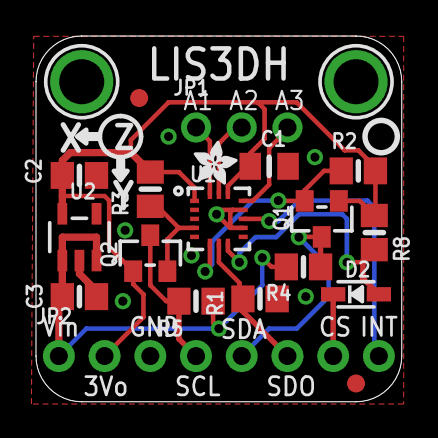
[picture p22: board Adafruit LIS3DH.brd from above]

Board: 2 copper layers, 20.3 x 20.3 mm, 23 parts (1 on the bottom side), 14 nets.

Other parts of the board:
U$9: PCBFEAT-REV-040
U$21: ADAFRUIT_2.5MM
U$22: ADAFRUIT_5MM
