RobotSwastaken/Amunicja/Hardware/Lokalizator/lokalizator.brd

## EAGLE design Hardware/Lokalizator/lokalizator.brd (2018-09-18)

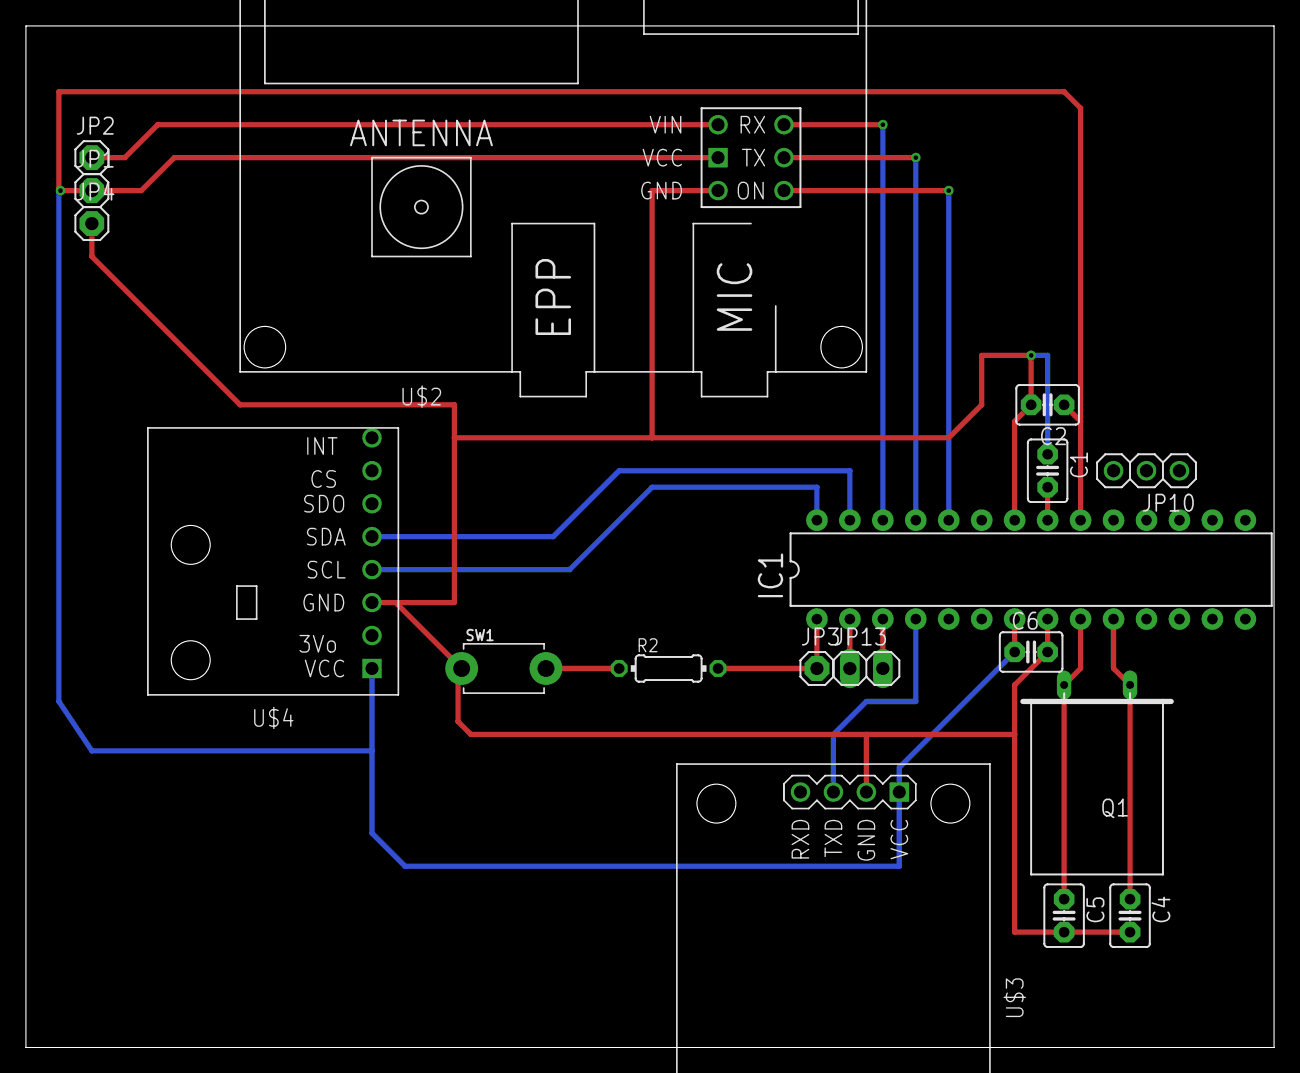
[picture p23: board lokalizator.brd from above]

Board: 2 copper layers, 96.2 x 78.7 mm, 18 parts (0 on the bottom side), 18 nets.

Parts:
C1, C2, C6: 100nF; C2.5-3
C4, C5: 22pF; C2.5-3
IC1: ATMEGA328PROUND; DIL28-3-ROUND
JP1, JP2, JP3, JP4: 1X01
JP10: 1X03
JP13: 1X02
Q1: Q
R2: 10k; 0204/7
SW1: TACT_PANA-EVQ
U$2: GSM-MODULE-G510; GSM-MODEM-SIM900A
U$3: GPS-RECEIVER-NEO6M
U$4: ACCELEROMETER SENSOR; LIGHT-SENSOR-BH1750

Connections:
GND: C1.1, C2.2, C4.2, C5.2, C6.2, IC1.8, IC1.22, JP4.1, SW1.P$1, U$2.4, U$3.2, U$4.2
unnamed: IC1.1, JP3.1, R2.2
unnamed: C1.2, IC1.21
unnamed: IC1.19, JP10.3
unnamed: C5.1, IC1.9, Q1.2
unnamed: IC1.18, JP10.2
unnamed: IC1.17, JP10.1
unnamed: C4.1, IC1.10, Q1.1
unnamed: IC1.27, U$4.4
unnamed: IC1.4, U$3.3
unnamed: IC1.24, U$2.1
unnamed: IC1.2, JP13.1
unnamed: IC1.3, JP13.2
unnamed: IC1.25, U$2.2
unnamed: IC1.26, U$2.3
unnamed: IC1.28, U$4.5
unnamed: R2.1, SW1.P$2
VCC: C2.1, C6.1, IC1.7, IC1.20, JP1.1, JP2.1, U$2.5, U$2.6, U$3.1, U$4.1
